xdr940/oscilloscope_89c52/README.md

# oscilloscope_89c52
base on 89c52 and display with two 8*8 square matrix

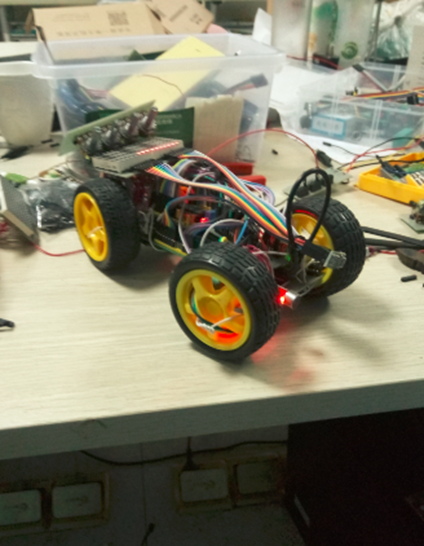
[picture p1: pics/overview.png]


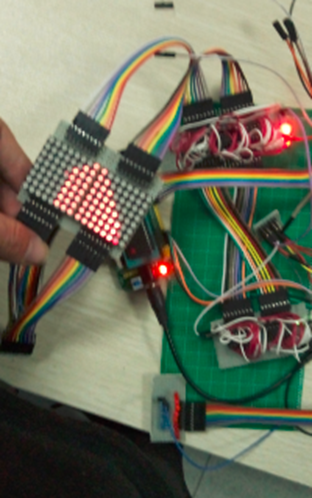
[picture p2: pics/display.png]


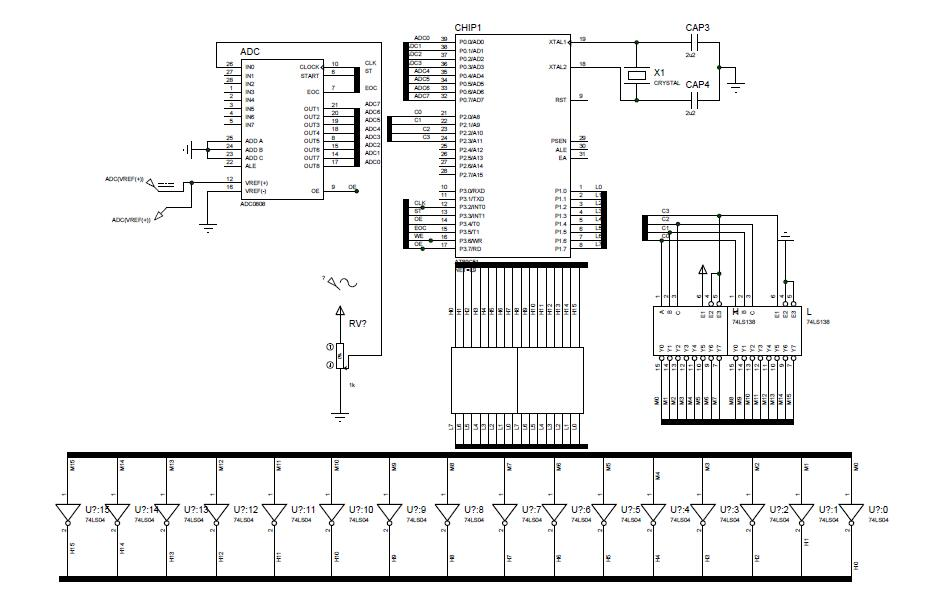
[picture p3: pics/circuit.jpg]
