xdr940/oscilloscope_89c52/docs/滤波.pptx

## 滤波的原理

## 滤波的分类

## Slide 3

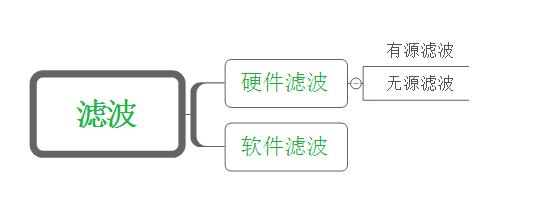
[picture p16: figure]

## 几种典型的无源滤波网络

## Slide 5

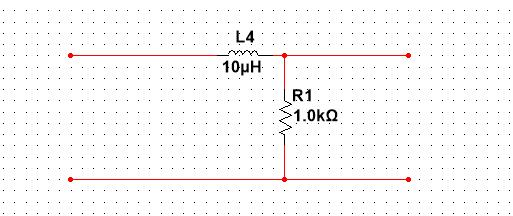
[picture p17: figure]

一阶滤波电路

网络函数(系统传递函数)：

输入输入关系：

## Slide 6

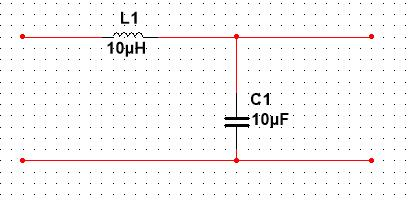
[picture p18: figure]

二阶RC滤波

网络函数（系统传递函数）

输入输出关系：

## Slide 7

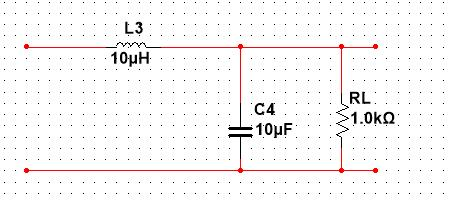
[picture p19: figure]

二阶RLC滤波

传递函数H(s) :

## Slide 8

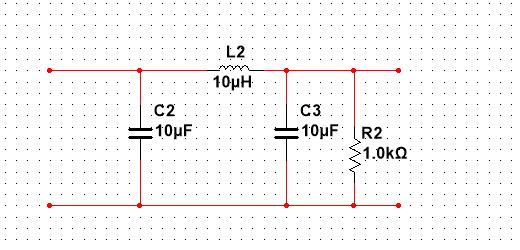
[picture p20: figure]

二阶LC-Π 型滤波

传递函数：

## Slide 9

## 一个例子

## Slide 11

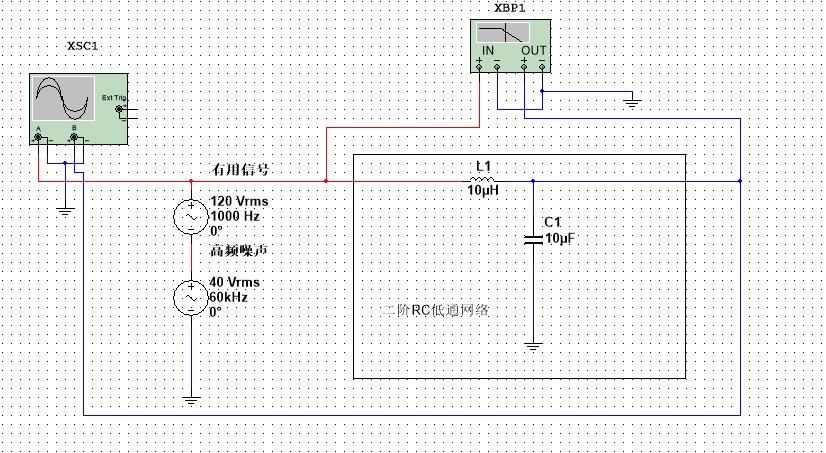
[picture p21: figure]

## Slide 12

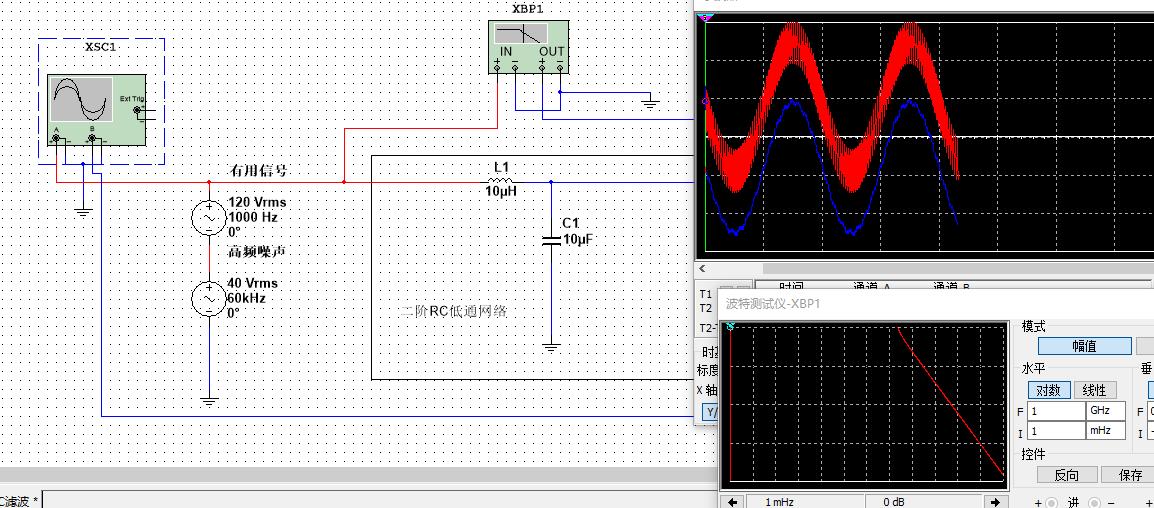
[picture p22: figure]

## Slide 13

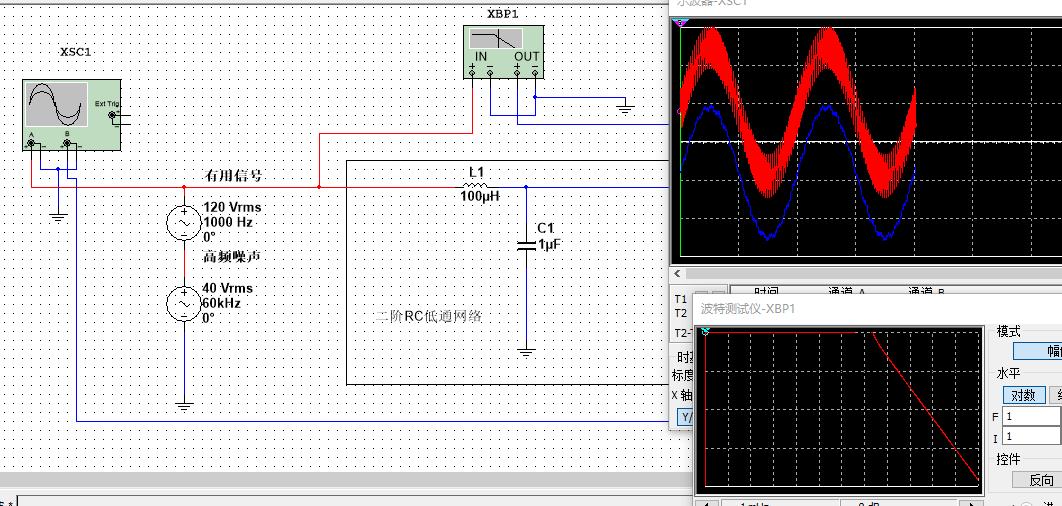
[picture p23: figure]

## Slide 14

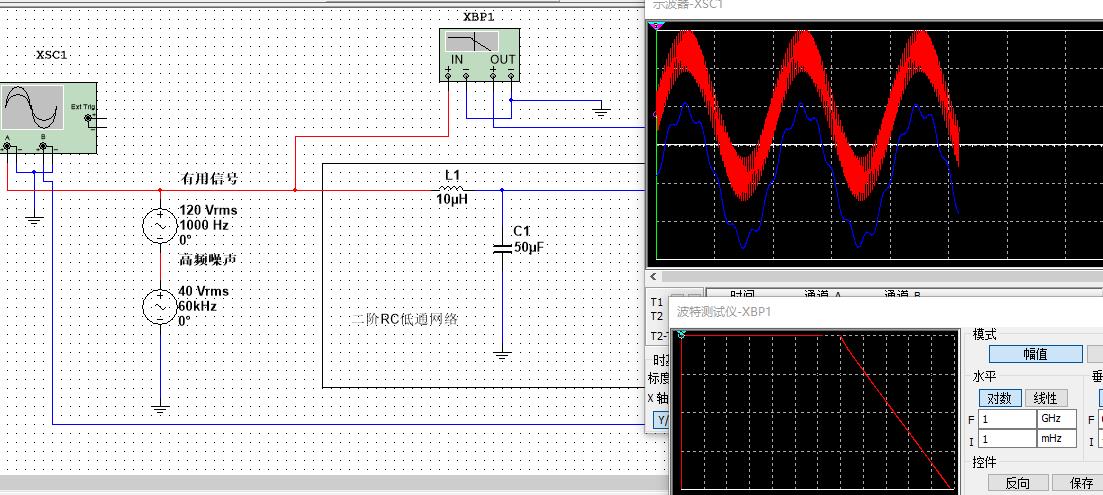
[picture p24: figure]

混进了低频成分↗

## 有源滤波器P318

## 一阶低通有源滤波

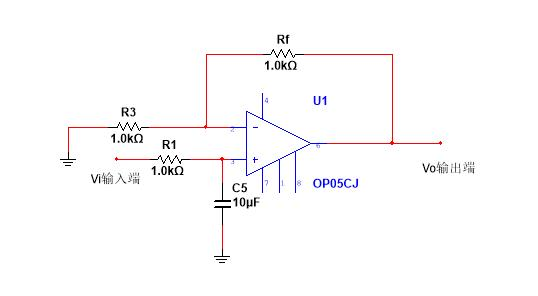
[picture p25: figure]

## 滤波芯片LTC1086

## Slide 18
