xdr940/oscilloscope_89c52/docs/原来打算的电路.PDF.pdf

U?:1

U?:0

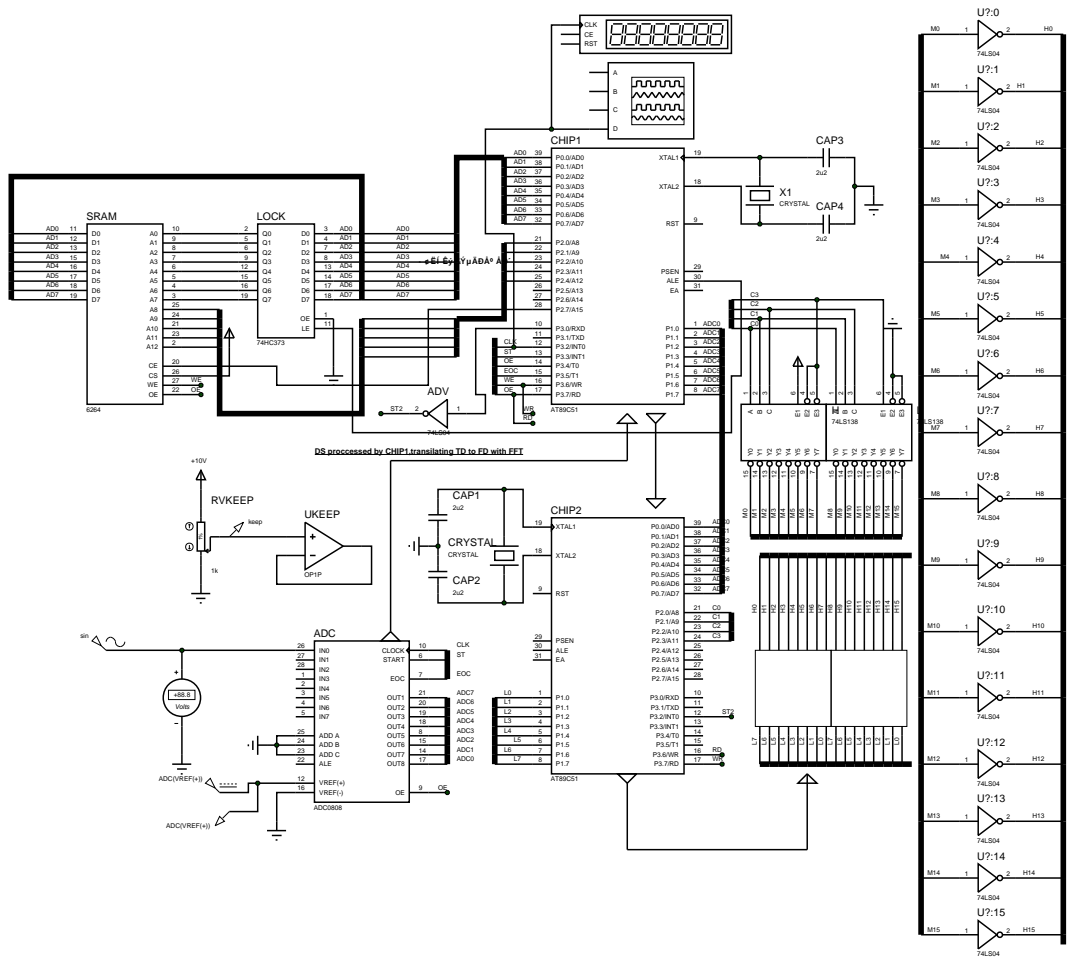
[picture p26: page 1]

C2
C1

DS proccessed by CHIP1,transilating TD to FD with FFT
