xdr940/oscilloscope_89c52/docs/实际电路.pdf

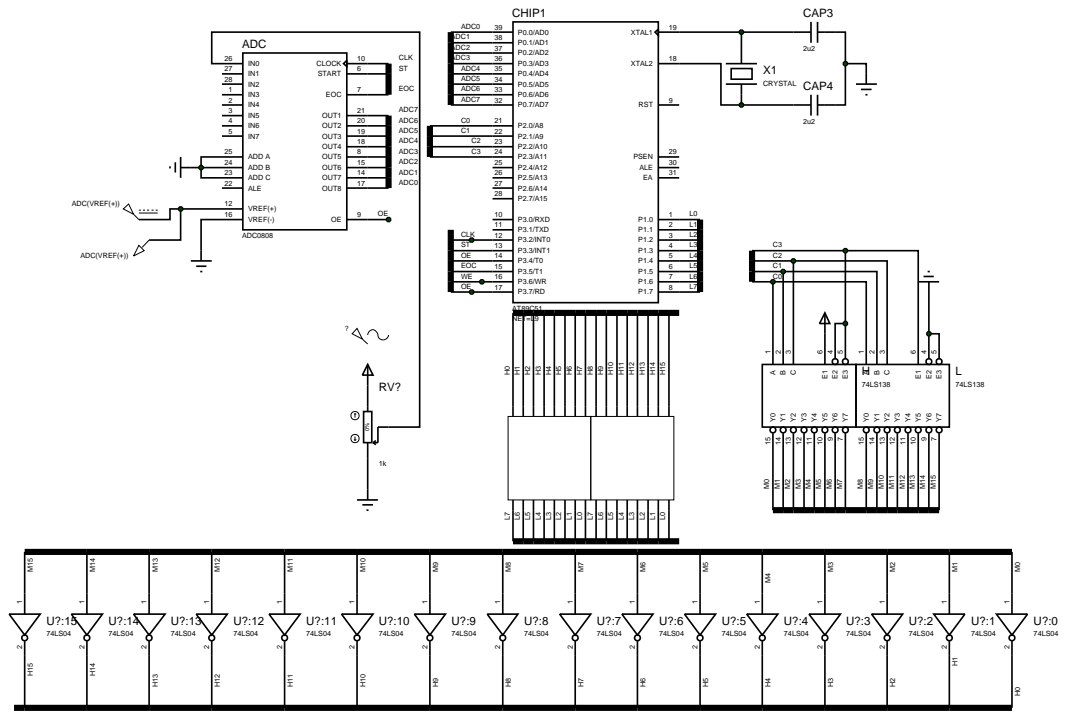
[picture p27: page 1]
