xdr940/oscilloscope_89c52/circuit/最后系统电路/最后的电路.pdf

## CHIP1

## CAP3

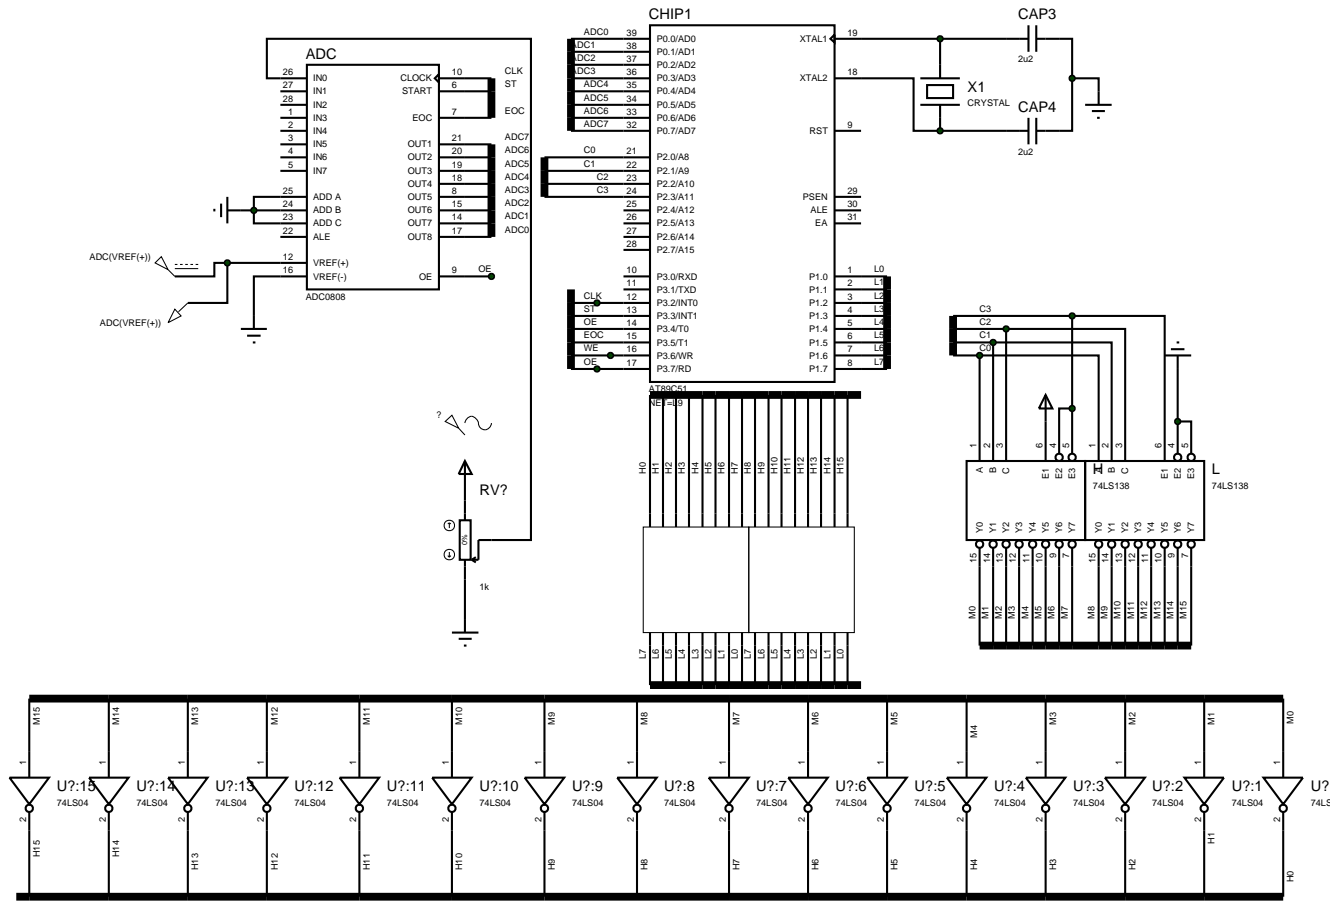
[picture p28: page 1]
