xdr940/oscilloscope_89c52/(list of files, drawings)

Other design files:
circuit/MCU通信电路/MCU2MCU.DSN
circuit/MCU通信电路/MCUsend.DSN
circuit/MCU通信电路/test2.DSN
circuit/MCU通信电路/频谱仪综合2.DSN
circuit/最后系统电路/频谱仪综合1.DSN
circuit/最后系统电路/频谱仪综合2.DSN
