xdr940/oscilloscope_89c52/docs/FFT_c_test.docx

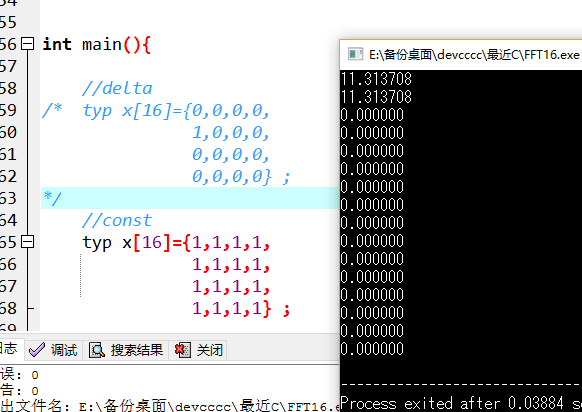
[picture p33: figure]
