xdr940/oscilloscope_89c52/docs/FFT_c_test.docx

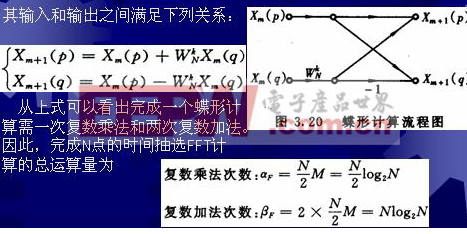
[picture p29: figure]
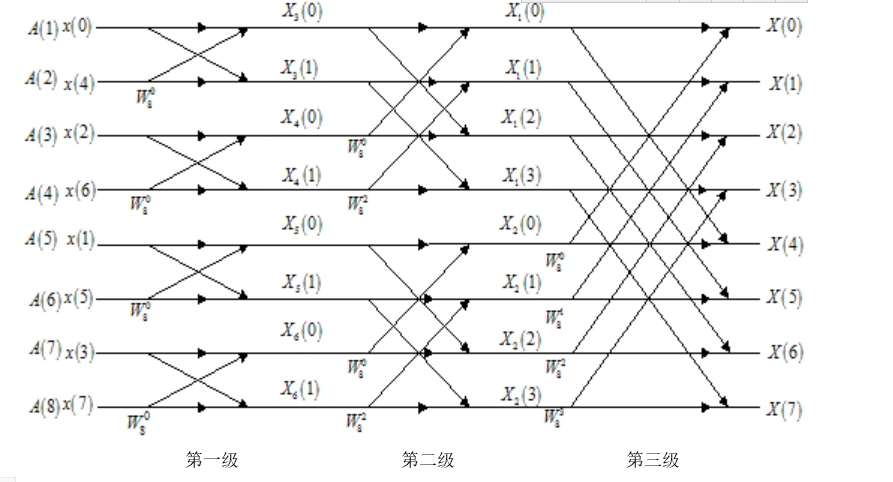
[picture p30: figure]
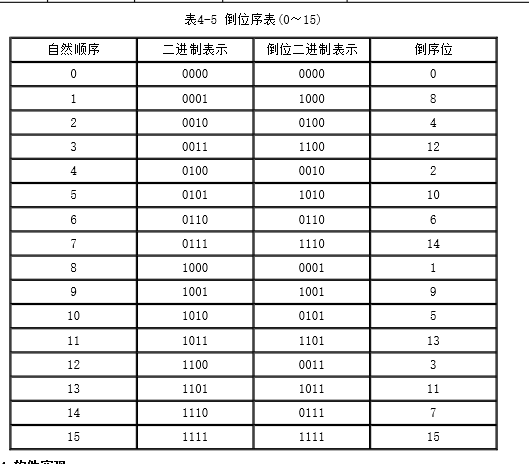
[picture p31: figure]

FFT效果

冲击函数δ FFT

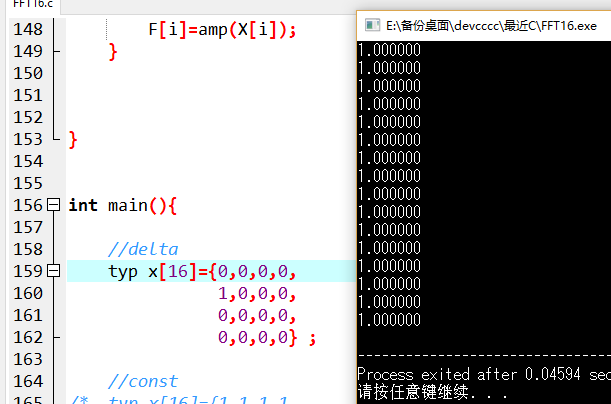
[picture p32: figure]

F(t)=1 FFT
